ru0aog/RP2040_beacon/README.md

# 🛰️ Автоматический КВ/УКВ-радиомаяк на RP2040

**RP2040_beacon** — это многофункциональный автоматический КВ/УКВ-радиомаяк, построенный на базе микроконтроллера RP2040 (с полной поддержкой миниатюрных плат **RP2040-Zero**). Проект ориентирован на радиолюбительские эксперименты, исследование прохождения радиоволн и оперативную передачу телеметрии в эфир.

> **Текущая версия:** `2.23` от `2026-10-15`

---

## ⚡ Основные возможности

* **Разнообразие цифровых режимов:** Поддержка классического **CW** (телеграф), **RTTY** (радиотелетайп), помехоустойчивого многочастотного **IFKP-0.5**, а также **OLIVIA 8/250**, **CONTESTIA 8/250**, **THOR 8/11**, **MFSK16**, **DominoEX 8**, **FSQ-4.5** и **JTTY** (4-FSK, свёрточный код K=10 + CRC-12, декодируется в **WSJT-X 3.3**) — с передачей **RSID-маркера режима** (fldigi сам переключает приёмник и центрует частоту по RxID; у FSQ и JTTY RSID не предусмотрен — принимающую программу нужно заранее переключить в нужный режим).
* **Гибкое формирование ВЧ-сигнала:** 
  * Штатный режим: работа с внешним высокоточным синтезатором частоты **Si5351**.
  * Аварийный/резервный режим: собственная **программная DDS-генерация меандра** с автотюнингом PLL и дизерингом MASH-2 на автоматах **PIO** (выполняется на изолированном ядре `Core 1`).
* **Умное сканирование шины I2C:** Автоматическое определение подключенной периферии (дисплей, датчики, часы реального времени) прямо при старте.
* **Автономная работа:** Встроенное расписание трансляций с привязкой к реальному времени.
* **Полноценная телеметрия:** Автоматическое формирование пакетов передачи, включающих системные параметры и климатические данные (температура, влажность, давление).
* **Удобное управление:** Текстовый конфигурационный файл на встроенном USB-диске платы и развитый консольный интерфейс через Serial-порт.

---

## 🎛️ Аппаратная часть и интерфейсы (Hardware)

Маяк спроектирован под аппаратную архитектуру чипа RP2040. Вся внешняя периферия подключается по общей шине **I2C**.

### Адреса I2C устройств

| Устройство / Модуль | Адрес на шине I2C | Назначение |
| :--- | :--- | :--- |
| **Si5351** | `0x60` | Основной внешний ВЧ-синтезатор частоты |
| **DS3231 / DS1307** | `0x68` | Модуль часов реального времени (RTC) |
| **LCD Дисплей** | `0x27` | Экран вывода системного статуса и параметров |
| **BME280 / BMP280** | Автосканирование | Климатический датчик (давление, температура, влажность) |
| **AT24Cxx** | Автосканирование | Внешняя энергонезависимая память EEPROM |

### Выход ВЧ-сигнала (VFO)
* **`GPIO 14`** — основной выходной пин для подключения к буферному усилителю или антенной цепи при работе встроенного PIO/DDS генератора (`VFO_OUTPUT_PIN = 14`).
* *Аппаратное ограничение программного DDS:* Обеспечивает чистую и стабильную сетку частот на КВ-диапазонах до **14–15 МГц**. На диапазоне 10 метров (28 МГц) генерация возможна, но упирается в пределы прямого делителя PIO. Для калибровки кварца используется параметр `VFO_CALIBRATED_XOSC_HZ`.

---

## 📦 Как скачать и установить готовую прошивку

Вам не обязательно устанавливать среды разработки для запуска маяка. Вы можете использовать полностью готовые бинарные файлы прошивки:

### 1. Официальные релизы (Рекомендуется)
Перейдите на страницу **[GitHub Releases](https://github.com/ru0aog/RP2040_beacon/releases)**. При создании каждого нового тега версии (`v*`) робот автоматически компилирует код и прикрепляет чистый файл **`.uf2`** в раздел *Assets*.

### 2. Свежие сборки «на лету»
Если вы хотите протестировать самые последние изменения, перейдите на вкладку **[GitHub Actions](https://github.com/ru0aog/RP2040_beacon/actions)**, выберите самый верхний успешный запуск сборки и скачайте архив артефакта **`arduino-rp2040-uf2`** из нижней части страницы.

### Инструкция по прошивке:
1. Зажмите аппаратную кнопку **BOOTSEL** на вашей плате (RP2040 / RP2040-Zero).
2. Не отпуская кнопку, подключите плату по USB-кабелю к компьютеру, после чего отпустите её.
3. В системе появится новый съемный накопитель **`RPI-RP2`**.
4. Просто **скопируйте (перетащите)** ваш скачанный `.uf2` файл на этот диск. Плата автоматически перезагрузится, применит прошивку и сразу начнет работу по заданному алгоритму.

---

## 💻 Сборка из исходного кода

Для самостоятельного изменения логики и локальной компиляции проекта вам понадобятся:

1. Среда разработки **Arduino IDE**.
2. Установленное стороннее ядро плат **Raspberry Pi Pico/RP2040** от *Earle F. Philhower* ([индекс плат](https://github.com/earlephilhower/arduino-pico/releases/download/global/package_rp2040_index.json)).
3. Библиотека **Adafruit TinyUSB Library**, установленная через стандартный менеджер библиотек.

### Конфигурация платы в Arduino IDE (FQBN):
При прошивке из IDE или сборке через CLI используйте следующие настройки:
* **Плата:** *Raspberry Pi Pico* (или аналогичная RP2040)
* **USB Stack:** *Adafruit TinyUSB*
* **Flash Size:** *2MB (Sketch: 1MB, FS: 1MB)* 
* *Строка FQBN для компилятора:* `rp2040:rp2040:rpipico:usbstack=tinyusb,flash=2097152_1048576`

---

## 🖥️ Интерфейс консольных команд (CLI)

Подключившись к плате через любой монитор Serial-порта (скорость 115200), вы можете гибко управлять маяком с помощью текстовых команд:

* **`?`** или **`help`** — вывод справочной информации и списка всех доступных команд.
* **`tele`** — мгновенный вывод текущей телеметрии (напряжение, аптайм, данные датчика BME/BMP280) в консоль.
* **`time`** — просмотр или ручная корректировка текущего времени.
* **`date`** — просмотр или корректировка текущей даты.
* **`text`** — изменение или просмотр текстовой строки, передаваемой маяком в эфир.
* **`setparam M=V`** — установка значения `V` для внутреннего параметра конфигурации `M`.
* **`start cw` | `rtty` | `ifkp` | `olivia` | `thor` | `contestia` | `mfsk16` | `dominoex` | `fsq` | `jtty`** — принудительный ручной запуск трансляции маяка в выбранном режиме модуляции.  
* **`jtty <текст>`** — одноразовая передача произвольного текста (до 80 символов) кадрами JTTY.  
* **`test jtty`** — самотест JTTY-кодека: побитовая проверка `pack28`, хэш-функции `ihashcall`, упаковки атомов и сборки кадра по эталонным векторам WSJT-X.  
* **`stop`** — мгновенная остановка текущей передачи и переход в режим ожидания.
* **`restart`** — программная перезагрузка маяка.
* **`reset`** — сброс всех измененных параметров к заводским настройкам по умолчанию.

---

## 📞 Эмулятор COM-модема (Hayes AT)

Модуль `hayes_modem.cpp` поднимает **второй виртуальный COM-порт** (второй USB CDC, дескриптор `Beacon Hayes Modem`) и имитирует Hayes-совместимый модем. CLI маяка остаётся на первом порту. Терминальные программы и софт, умеющий работать с модемом (HyperTerminal, PuTTY, minicom, скрипты), могут управлять маяком AT-командами и передавать текст в эфир.

**Набор номера = выбор режима эфира:** `ATD<режим>,<частота Гц>`

| Номер | Режим | Частота по умолчанию |
| :---: | :--- | :--- |
| `0`  | Локальная петля (эхо, для проверки) | — |
| `1`  | CW | `FREQ_CW` |
| `2`  | RTTY | `RTTY_MARK` (+ `RTTY_SHIFT`, `RTTY_INV`) |
| `3`  | IFKP | `FREQ_IFKP` |
| `4`  | OLIVIA | `FREQ_OLIVIA` |
| `5`  | THOR | `FREQ_THOR` |  
| `6`  | CONTESTIA | `FREQ_CONTESTIA` |
| `7`  | MFSK16 | `FREQ_MFSK16` |
| `8`  | DOMINOEX (DominoEX 8) | `FREQ_DOMINOEX` |
| `9`  | FSQ (FSQ-4.5) | `FREQ_FSQ` |
| `10` | JTTY | `FREQ_JTTY` |

Например, команда ATD1,3510000 переведёт маяк на частоту 3510 кГц, все последующие вводимые символы уйдут в эфир в режиме CW.
После этого команда +++ поданная с защитными паузами по 1 сек в начале и конце переведёт модем обратно в режим команд.
`ATO` — обратно в режим данных, `ATH` — отбой.
Если маяк в этот момент работает по расписанию, ответ — `BUSY`.
Команды `stop`/`restart` и запись файлов с ПК прерывают передачу (`NO CARRIER`). Разъединение от порта отключает модем.

**Поддерживаемые команды:** `AT`, `A/`, `ATZ`, `AT&F`, `AT&W` (профиль хранится в ОЗУ до перезагрузки), `AT&V`, `ATE0/1`, `ATV0/1`, `ATQ0/1`, `ATX0..4`, `ATF0/1` (эхо в режиме данных), `ATI0..4`, `ATSn=v`, `ATSn?`, `ATH`, `ATO`, `ATA`, `ATD…`, `ATDL` (повтор номера), `AT&D0..3` (реакция на сброс DTR). `ATL/M/B/N/Y/P/T`, `AT&C/&K/&S…`, `AT\…`, `AT%…` принимаются и игнорируются.

Пример сеанса:
```
AT
OK
ATD2,3585000
CONNECT 115200
CQ CQ DE RU0AOG
+++
OK
ATH
OK
```
---
### Режим JTTY  
  
* Порт протокола JTTY из WSJT-X 3.3: 4-FSK, символ 32 мс, кадр 59 символов (13 синхротонов + 46 кодированных), свёртка K=10 с полиномами `0o1167/0o1545`, CRC-12 `0x80F`, Gray-кодирование дибитов. Полоса 4 тона с шагом 31.25 Гц, длительность кадра 1.888 с. Частота задаётся параметром `FREQ_JTTY` (центр полосы; нижний тон = `FREQ_JTTY − 46.875 Гц`).
---

## 📚 Документация и ссылки

* Полная база знаний проекта, подробное описание регистров DDS и схемы подключения модулей доступны на **[DeepWiki](https://deepwiki.com/ru0aog/RP2040_beacon)**.
* Исходный код автоматизации сборки: [.github/workflows/arduino_build.yml](./.github/workflows/arduino_build.yml).

---

## ⚖️ Лицензия и авторы

* **Автор проекта:** [@ru0aog](https://github.com/ru0aog)
* Проект является открытым. Исходный код распространяется под лицензией **GPLv3** (см. файл [LICENSE](LICENSE)).  
* **Уведомление об авторских правах третьих лиц:**
1. модули `olivia_modem.cpp` и `thor_modem.cpp` содержат код, портированный из проекта [fldigi](https://sourceforge.net/projects/fldigi/) (GPLv3) — алгоритмы MFSK/Walsh-кодирования и RSID (© Pawel Jalocha SP9VRC, David Freese W1HKJ).
2. Varicode в `thor_modem.cpp` реализован по спецификации IZ8BLY / ZL1BPU MFSK standard.
3. Общий MFSK-движок `thor_modem.cpp` (THOR, MFSK16, DominoEX 8, FSQ) и генератор RSID портированы из файлов fldigi: `thor/thor.cxx`, `mfsk/mfsk.cxx`, `mfsk/mfskvaricode.cxx`, `mfsk/interleave.cxx`, `thor/thorvaricode.cxx`, `dominoex/dominoex.cxx`, `dominoex/dominovar.cxx`, `fsq/fsq.cxx`, `fsq/fsq_varicode.cxx`, `rsid/rsid.cxx`, `rsid/rsid_defs.cxx`.
4. JTTY-модем (`jtty_modem.cpp`) — порт протокола JTTY из **WSJT-X 3.3** (© Joe Taylor K1JT и соавт., GPLv2): упаковка сообщений `pack_jtty`, `pack28`/`ihashcall` из `packjt77`, свёрточный код TBCC K=10 и CRC-12 из `tbcc.f90`.
