ru0aog/RP2040_beacon/Beacon v2_10 SCH.JPG

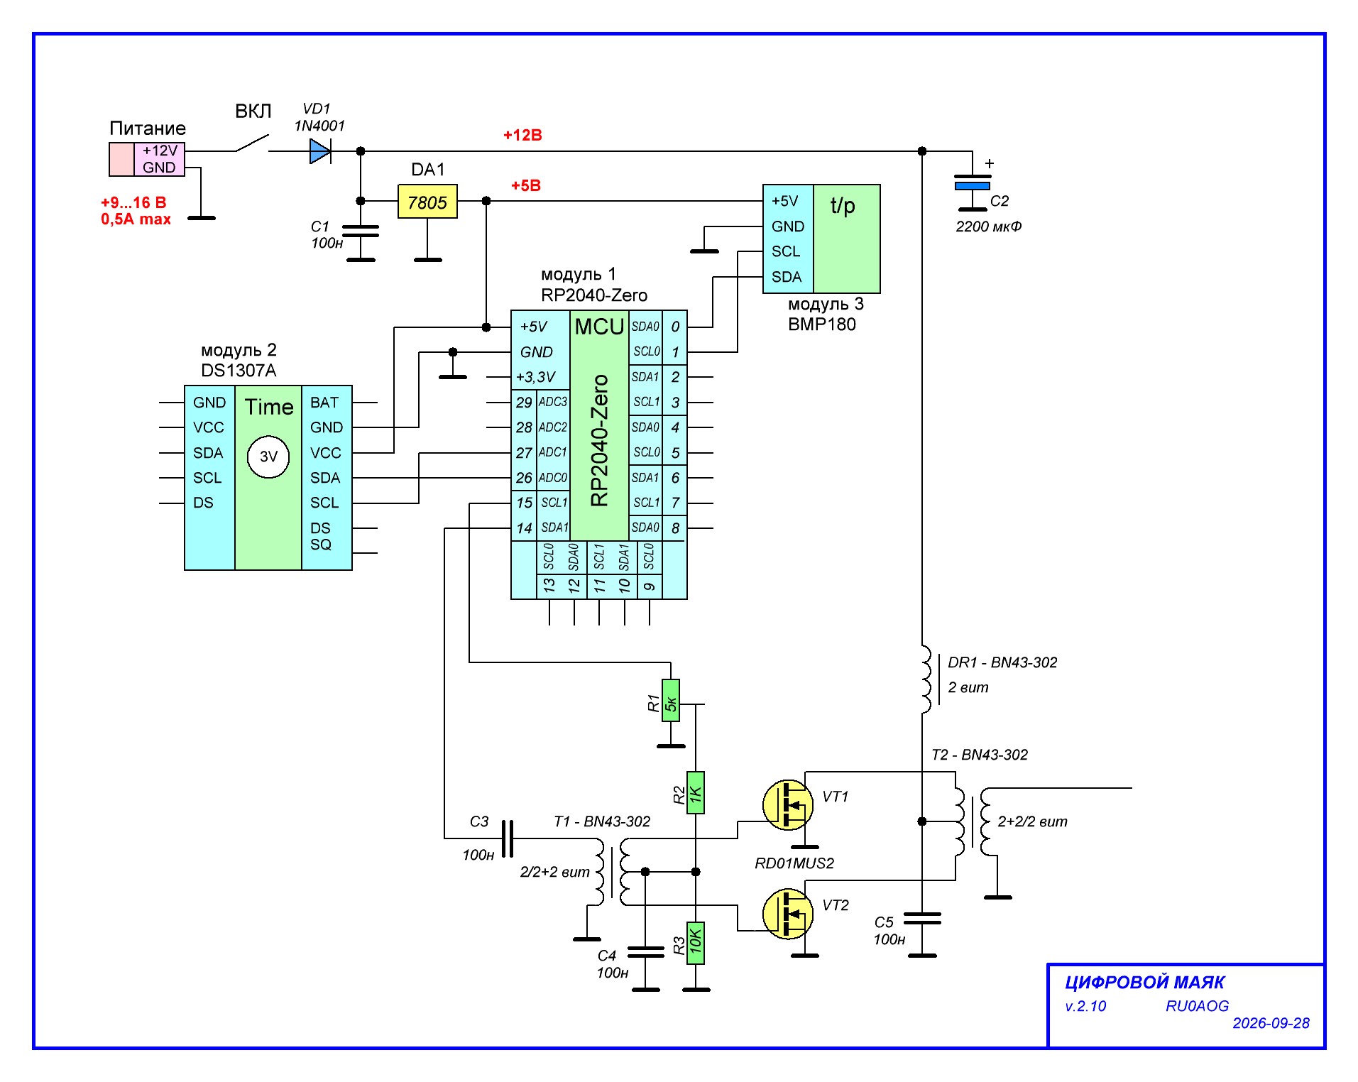
Beacon v2_10 SCH.JPG
