ru0aog/RP2040_beacon/Beacon v2_26 SCH.JPG

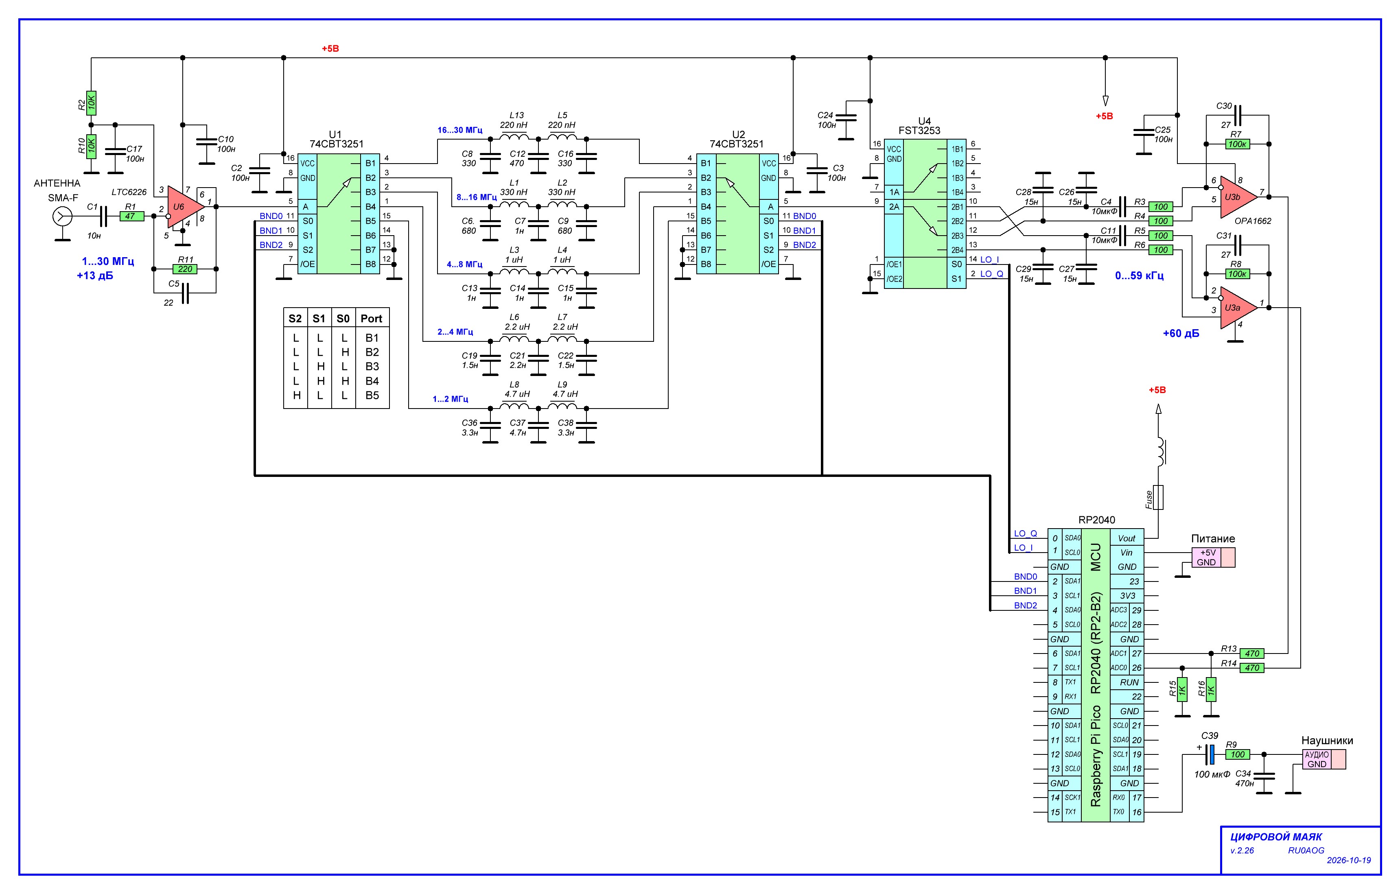
Beacon v2_26 SCH.JPG
