ru0aog/RP2040_beacon/(list of files, drawings)

Other design files:
Beacon v2_10 SCH.spl7
Beacon v2_26 SCH.spl7
