ru0aog/RP2040_beacon/rx_dsp.cpp

/**  
 * ============================================================================  
 *  rx_dsp.cpp — модуль децимирующего DSP-тракта (core1)  
 *  Версия 2.26 от 2026-10-20, автор RU0AOG  
 *  
 *  Тракт: 32-бит слова [I|Q] из rx_capture → центрирование → NCO-сдвиг →  
 *  3 каскада half-band FIR (/8) → SPSC-очередь базовой полосы  
 *  int16 I/Q по 64 отсчёта на блок.  
 *  
 *  Fs на канал = RX_ADC_SAMPLE_RATE_HZ/2 (~125 ksps при 250k слов/с),  
 *  Fs_out = Fs/8 ≈ 15.6 ksps на канал (Nyquist ±7.8 кГц — покрывает  
 *  полосу всех узкополосных модов и ПЧ-сдвиг).  
 * ============================================================================  
 */  
  
#include <Arduino.h>  
#include "vfo_hardware.h"  
#include "pico/multicore.h"  
  
// ---- Параметры тракта ----  
#define RX_FS_IN_HZ           (RX_ADC_SAMPLE_RATE_HZ / 2.0f)    // Fs на канал  
#define RX_DECIM_STAGES       3                                 // кол-во последовательных КИХ-фильтров (3)
#define RX_FS_OUT_HZ          (RX_FS_IN_HZ / 8.0f)              // ~15.6 ksps при 250k  
  
// NCO: 32-битный фазовый аккумулятор  
static volatile uint32_t nco_phase = 0;  
static volatile uint32_t nco_step  = 0;     // 2^32 * f_nco / Fs_in  
  
// sin/cos LUT: 1024 точки, Q15, квадратурная пара  
// табличная генерация опорного гармонического сигнала (LUT — Look-Up Table)
static int16_t nco_lut[1024];       // таблица LUT 1024*16бит = 2 кБ
// Функция заполняет таблицу одним полным периодом идеальной синусоиды
// на целочисленном CPU функция медленная!
static void nco_lut_init(void) {
    for (int i = 0; i < 1024; i++)  
        nco_lut[i] = (int16_t)(32767.0f * sinf(2.0f * PI * i / 1024.0f));  
}
// быстрое извлечение квадратурной пары (синуса и косинуса) из заранее подготовленной таблицы
static inline void nco_sincos(uint32_t ph, int16_t* s, int16_t* c) {  
    uint16_t idx = ph >> 22;                // Битовый сдвиг фазы. Старшие 10 бит
    *s = nco_lut[idx];                      // Извлечение синуса
    *c = nco_lut[(idx + 256) & 1023];       // Извлечение косинуса. cos = sin сдвинутый на 90°  
}  
  
// ---- Half-band FIR, 15 отводов, коэффициенты для децимации на 2 ----  
// Стандартный HB-фильтр с окном Хэмминга: в массиве нулевые элементы находятся на нечётных индексах 1, 3, 5, 9, 11 и 13. 
// Центральный индекс - 7. Общий масштаб 1.0 = 32768
// Коэффициенты представлены в целочисленном формате фиксированной запятой Q15
// Симметричные коэффициенты обеспечивают линейную фазу и постоянную групповую задержку в рабочей полосе.
// Это не означает полного отсутствия фазового сдвига.
// Нулевые коэффициенты теоретически позволяют исключить часть операций умножения при оптимизации компилятором
static const int16_t hb_taps[15] = {
    -120,     0,   532,     0, -2250,
       0, 10030, 16384, 10030,     0,
    -2250,     0,   532,     0,  -120
};
#define HB_NTAPS 15        // 15 отводов

typedef struct {
    int32_t d[HB_NTAPS];   // линия задержки (накопленные I или Q)  
    uint8_t w;             // указатель записи  
    uint8_t phase;         // свой бит чётности на каждый канал — I и Q независимы  
} hb_state_t;

static hb_state_t hb_i[RX_DECIM_STAGES], hb_q[RX_DECIM_STAGES];

// реализует один шаг фильтрации и децимации (прореживания) данных через Half-Band FIR (КИХ) фильтр
static inline bool hb_push(hb_state_t* st, int32_t x, int32_t* out) {
    // Новый входящий отсчёт x записывается в историю фильтра (линию задержки st->d) по текущему указателю записи st->w
    st->d[st->w] = x;
    // Указатель st->w сдвигается на следующий элемент
    // Операция % HB_NTAPS (в данном случае % 15) зацикливает массив,
    // обеспечивает циклический переход индекса в программном коде, который компилятор может оптимизировать.
    st->w = (st->w + 1) % HB_NTAPS;
    // Прореживание частоты на 2
    st->phase ^= 1;     // Переменная st->phase это однобитный триггер чётности 
    // (флаг, который при каждом вызове функции переключается между 0 и 1 с помощью операции XOR ^= 1)
    // Если шаг нечётный (st->phase == 1), функция просто сохраняет семпл в историю и мгновенно выходит, возвращая false
    if (st->phase) return false;      // нечётный вход — выхода нет
    // Математическое вычисление свертки КИХ-фильтра
    int32_t acc = 0;    // аккумулятор сбрасывается в ноль
    // Запускается цикл свертки на 15 отводов (HB_NTAPS)
    for (int k = 0; k < HB_NTAPS; k++) {
        // быстрое вычисление правильного физического индекса внутри кольцевого массива, 
        // начиная от самой старой сохраненной точки к самой новой
        int idx = (int)st->w + k; if (idx >= HB_NTAPS) idx -= HB_NTAPS;
        // цифровое умножение отсчёта сигнала на соответствующий коэффициент фильтра (hb_taps)
        acc += (int32_t)st->d[idx] * hb_taps[k];  
    }
    // Масштабирование и выдача готового отсчёта
    *out = acc >> 15;
    return true;
}

// 16-битный ограничитель
static inline int16_t sat16(int32_t v) {
// Если значение превысило верхний порог 32767, оно жестко ограничивается до максимума 32767
// Если значение ушло ниже минимального порога -32768, оно ограничивается снизу до -32768
// Если значение находится в безопасных пределах, оно возвращается без изменений
    if ((v >> 15) ^ (v >> 31)) {
        return (v >> 31) ^ 0x7FFF;
    }
    return (int16_t)v;
}

#define RX_OUT_SAMPLES   (RX_BLOCK_SAMPLES / 8)     // 64 пары отсчётов I/Q на блок  
#define RX_OUT_BUFS      4                          // кол-во выходных буферов

static int16_t out_i[RX_OUT_BUFS][RX_OUT_SAMPLES];  // выходные буферы обработанных данных I/Q
static int16_t out_q[RX_OUT_BUFS][RX_OUT_SAMPLES];
static volatile uint8_t  out_head = 0;              // запись: только core1  
static volatile uint8_t  out_tail = 0;              // запись: только core0  
static volatile uint32_t out_dropped = 0;           // диагностика переполнений  
static int32_t dc_i = 2048 << 8;
static int32_t dc_q = 2048 << 8;

// бесконечный изолированный рабочий цикл ядра Core 1
// цифровой преобразователь частоты вниз (DDC — Digital Down Converter)
static void __not_in_flash_func(rx_dsp_entry)(void) {  
    // бесконечный цикл ядра Core 1
    while (true) {
        // кормим собачку
        watchdog_update();
        // проверяем очередь АЦП (функция в rx_capture.cpp)
        const volatile uint32_t* blk = rx_capture_get_block();
        // если данных ещё нет - на следующую итерацию
        if (!blk) {
            tight_loop_contents();  // подсказка компилятору для цикла ожидания; в этой итерации новых данных нет
            continue;
        }
        // данные из DMA пришли
        uint8_t wr        = out_head;                           // индекс текущего свободного буфера выходной очереди
        uint8_t next_head = (uint8_t)((wr + 1) % RX_OUT_BUFS);  // следующий шаг кольцевого буфера
        // Если очередь полна (queue_full == true), код не останавливает работу. 
        // Блок всё равно будет обработан, чтобы не разорвать внутренние состояния 
        // цифрового гетеродина и фильтров, но результат в конце будет просто сброшен в мусорку.
        bool    queue_full = (next_head == out_tail);
        uint8_t n_out = 0;
        // устанавливаем указатель
        const volatile int16_t* s = (const volatile int16_t*)blk;
        // DMA_SIZE_16: каждое 32-битное слово FIFO = пара отсчётов  
        // [15:0] = ADC0 (I), [31:16] = ADC1 (Q). Пар в блоке = RX_BLOCK_SAMPLES. 
        // внутренний цикл обработки блока данных. Обрабатываем пары I/Q
        for (int n = 0; n < RX_BLOCK_SAMPLES; n++) {
            // извлекаем текущие отсчёты из массива
            int32_t i_meas = s[2 * n];
            int32_t q_meas = s[2 * n + 1];
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
