ru0aog/RP2040_beacon/scheduler.cpp

/**  
 * ============================================================================  
 *  scheduler.cpp — Низкоуровневый драйвер RTC шины I2C и планировщик задач  
 *  Версия 2.12 от 2026-10-01, автор RU0AOG  
 * ============================================================================  
 *  
 *  НАЗНАЧЕНИЕ  
 *  ----------  
 *  Обеспечивает прецизионный учет системного времени/даты и управляет запуском  
 *  сеансов связи радиомаяка по усложненным периодическим и одиночным сценариям.  
 *  
 *  ТРЕХКОНТУРНОЕ АВТООПРЕДЕЛЕНИЕ RTC И ФИКСАЦИЯ ЧАСТОТЫ АЦП  
 *  -------------------------------------------------------  
 *  Драйвер работает напрямую с регистрами I2C (адрес 0x68) без внешних библиотек:  
 *  1. Высокоточный DS3231: Выбирается базовым при успешном пинге шины.  
 *  2. Стандартный DS1307А: Определяется по маске NVRAM регистра 0x0F. Принудительно  
 *     сбрасывает бит CH (Clock Halt) в регистре секунд для запуска осциллятора.  
 *  3. Внутренний RTC чипа RP2040: Включается, если внешние чипы не найдены.  
 *     [Аппаратный хак]: При переходе на внутренний RTC тактирование clk_rtc переводится  
 *     на PLL_SYS, а частота clk_peri жестко фиксируется на PLL_SYS, что намертво  
 *     стабилизирует тактовую частоту АЦП и убирает разбег показаний телеметрии.  
 *  
 *  МАТРИЧНЫЙ ПЛАНИРОВЩИК (is_time_to_transmit)  
 *  -------------------------------------------  
 *  Поминутно проверяет массив beacon_schedule (до 32 задач). Поддерживает  
 *  фильтрацию по битовой маске дней недели rtc_dotw (1=Пн..7=Вс), разовые пуски  
 *  и циклические окна, в том числе со сквозным переходом через полночь  
 *  (расчет hit = (cur >= st || cur <= en)). Защищает от повторного запуска в ту же минуту.  
 *  
 *  АНТИШУМОВАЯ СТАБИЛИЗАЦИЯ АЦП ТЕЛЕМЕТРИИ  
 *  ---------------------------------------  
 *  get_telemetry_string(): Перед замером температуры кристалла RP2040  
 *  полностью останавливает аппаратную I2C шину часов (pWire->end()), переводит  
 *  пины I2C (26 и 27) в режим обычных цифровых выходов и жестко выдает на них  
 *  HIGH (+3.3 В). Это принудительно запитывает «висящий» внутренний опорный узел  
 *  АЦП, полностью убирая шумы и утечки при замере на канале 4.  
 *  
 *  ПУБЛИЧНЫЙ API  
 *  -------------  
 *  init_scheduler()           — обнаружение чипа и запуск источника времени.  
 *  update_scheduler()         — обновление глобальных переменных времени.  
 *  get_current_time/date()    — строки времени/даты.  
 *  print_current_time/date()  — вывод в Serial.  
 *  get_telemetry_string()     — строка "T_DS=.. T_CPU=..".  
 *  is_time_to_transmit(mode)  — проверка расписания для режима.  
 *  handle_time_command / handle_date_command — установка времени/даты из UART.  
 *  
 *  ИСПОЛЬЗУЕМЫЕ БИБЛИОТЕКИ И МОДУЛИ  
 *  -------------------------------  
 *  - Raspberry Pi Pico SDK (BSD-3): hardware/adc.h, hardware/rtc.h,
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
