ru0aog/RP2040_beacon/(commit log)

2026-10-06 Add files via upload
    оптимизирован цикл дизеринга
2026-10-09 Add files via upload
    Калибровка frac_spur_level_db (−21 dB).
    Уровень спура в метрике + FORB-арбитраж с 2⁴⁰-штрафом.
    Ненулевая монотонная метрика позиции/уровня спура.
    Адаптивный гейт clk·int (устранил SCAN EMPTY на 21/28 МГц).
    Рантайм-маска FRAC-дизера по int (вернула ближнюю зону на ВЧ).
